azimlabsalk/Tactile-Orienting-Task/README.md

# Tactile-Orienting-Task

[Readme](https://github.com/azimlabsalk/Tactile-Orienting-Task/blob/main/Azim%20Lab_Tactile%20Orienting%20Task_README.pdf)
