azimlabsalk/Tactile-Orienting-Task/Tactile Orienting Task_files/PCB/PCB_fab_files/Bill_of_Materials-rotary_table_v2.xlsx

Comment | Value | VoltageRating | Description | Quantity | Designator | Footprint | LibRef | Manufacturer | MfgPartNumber | DigikeyPartNumber | MouserPartNumber | NP
DRV8838DSGR |  |  | IC BRIDGE DRIVER PAR 8WSON | 1 | U1 | WSON-8_PAD | DRV8838DSGR | Texas Instruments | DRV8838DSGR | 296-40081-1-ND
Green |  |  | LED | 8 | LED1, LED2, LED3, LED4, LED5, LED6, LED7, LED8 | LED0603 | LED | Wurth Elektronik | 150060VS75000 | 732-4980-1-ND
100nF | 100nF | 25V | Nonpolarized capacitor | 2 | C1, C2 | C0603 | CAP | Samsung | CL10B104KC8VPNC | 1276-CL10B104KC8VPNCCT-ND
1-1337543-0 |  |  | Female Connector, Pitch 2.54 mm, 1 x 2 Position, Height 15.8 mm, Tail Length 3.8 mm, -55 to 85 degC, RoHS, Bulk | 1 | J1 | TECO-1-1337543-0_V | CMP-2000-05853-1 | TE Connectivity |  | A97553-ND
DMN1019 |  |  | MOSFET N-CH 12V 9.3A SC59 | 1 | Q1 | SC59-3 | DMN1019UVT | Diodes Incorporated | DMN1019USN-7 | DMN1019USN-7DICT-ND
DF3EA-2P-2V(21) |  |  | CONN HEADER SMD 2POS 2MM | 1 | J4 | DF3EA-2P-2V(21) | DF3EA-2P-2V(21) | Hirose | DF3EA-2P-2V(21) | H125461CT-ND
D2510-6002-AR |  |  | CONN HEADER 10POS VERT 10GOLD | 1 | J3 | D2510-6002 | D2510-6002-AR | 3M |  | MHC10E-ND
Resistor | 10K |  | Resistor | 9 | R1, R2, R3, R4, R5, R6, R7, R8, R9 | R0603 | RES | Stackpole | RMCF0603FT10K0 | RMCF0603FT10K0CT-ND
header_40_male_dummy |  |  | row of 40 pins breakaway male 2.54mm | 2 | DUMMY1, DUMMY2 |  | header_40_male_dummy | Sullins | PRPC040SAAN-RC | S1011EC-40-ND
SI2305 |  |  | P-CHANNEL MOSFET, SOT-23 PACKAGE | 1 | Q2 | SOT23-3 | SI2305 | Micro Commercial Co | SI2305-TP | SI2305-TPMSCT-ND
