azimlabsalk/Tactile-Orienting-Task/Tactile Orienting Task_files/CAD/Assem3_all/Assem3_front.SLDASM

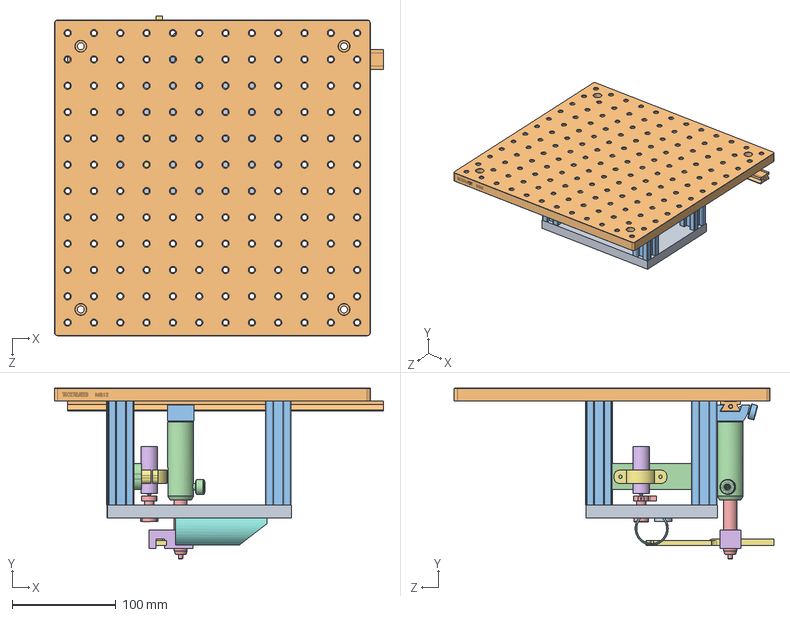
[picture p1: CAD file, 2021-02-10]
Tactile Orienting Task_files/CAD/Assem3_all/Assem3_front.SLDASM
317.5 x 165.0 x 308.4 mm
MB12-Solidworks
Colum x 4
Base plate v1
MOTOR HOLDER
190815 tuntable 14mm_v3_1.65mm_hole_side
Maxon Motor
SK_Motorclamp
ANIMLA HOLDER TUBE
ARM REST
RLA1200-Solidworks
RC1-Solidworks
PH3-Solidworks
TR3-Solidworks
headfix_joint
190604_unicorn_headpost_v1_mirror
