azimlabsalk/Tactile-Orienting-Task/Tactile Orienting Task_files/CAD/Assem3_all/ARM REST.SLDPRT

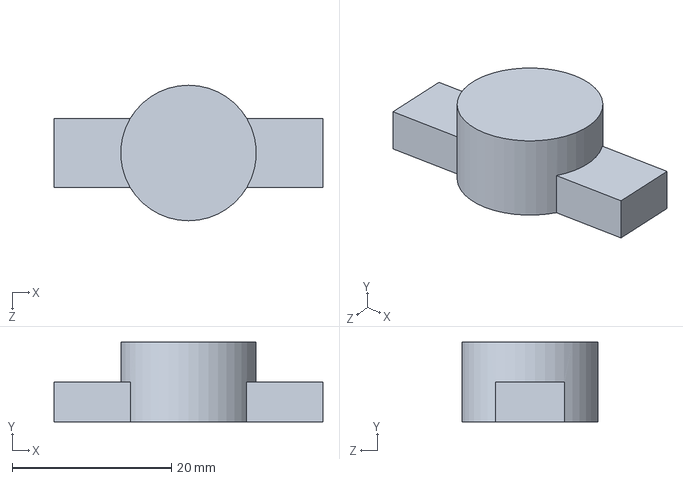
[picture p2: CAD file, 2021-02-10]
Tactile Orienting Task_files/CAD/Assem3_all/ARM REST.SLDPRT
33.7 x 10.0 x 17.0 mm
