azimlabsalk/Tactile-Orienting-Task/Tactile Orienting Task_files/CAD/Assem3_all/headfix_joint.SLDPRT

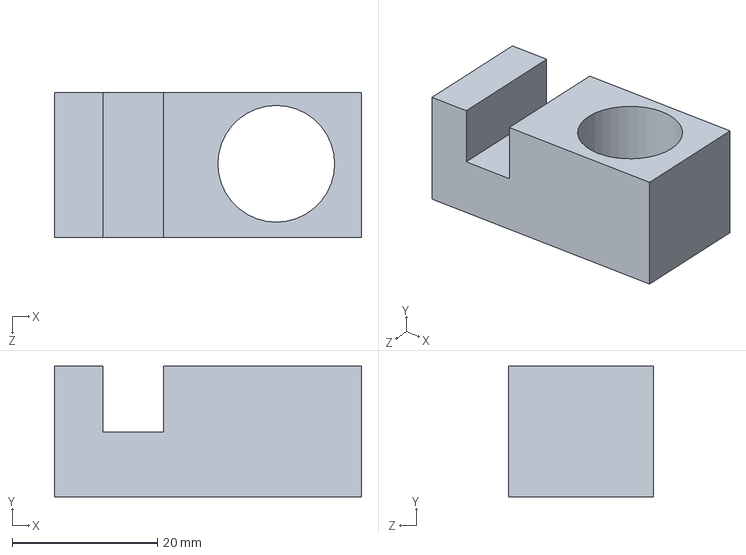
[picture p3: CAD file, 2021-02-10]
Tactile Orienting Task_files/CAD/Assem3_all/headfix_joint.SLDPRT
42.3 x 18.0 x 20.0 mm
