azimlabsalk/Tactile-Orienting-Task/Tactile Orienting Task_files/CAD/Assem3_all/MOTOR HOLDER.SLDPRT

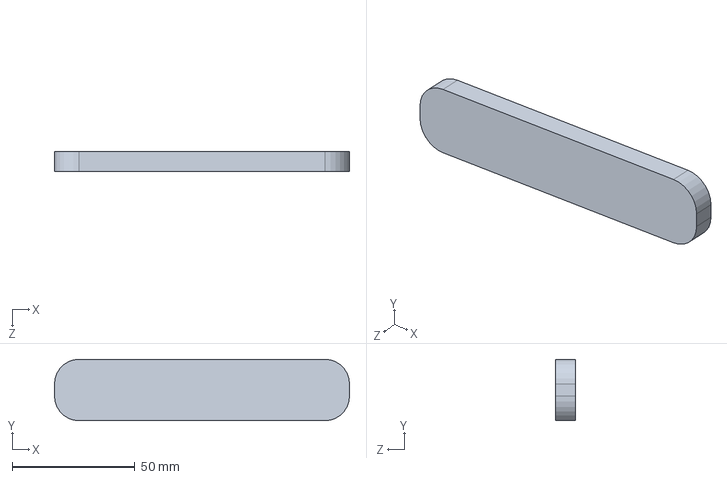
[picture p4: CAD file, 2021-02-10]
Tactile Orienting Task_files/CAD/Assem3_all/MOTOR HOLDER.SLDPRT
120.0 x 25.0 x 8.00 mm
