azimlabsalk/Tactile-Orienting-Task/Tactile Orienting Task_files/CAD/Assem3_all/PH3-Solidworks.SLDPRT

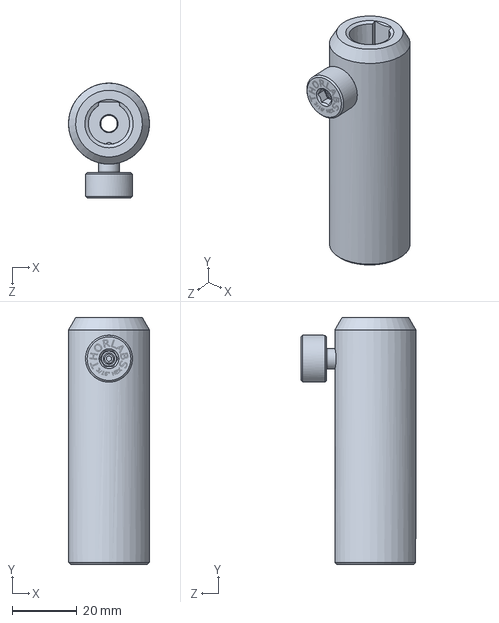
[picture p5: CAD file, 2021-02-10]
Tactile Orienting Task_files/CAD/Assem3_all/PH3-Solidworks.SLDPRT
25.0 x 76.2 x 35.4 mm
