azimlabsalk/Tactile-Orienting-Task/Tactile Orienting Task_files/CAD/Assem3_all/Base plate v1.SLDPRT

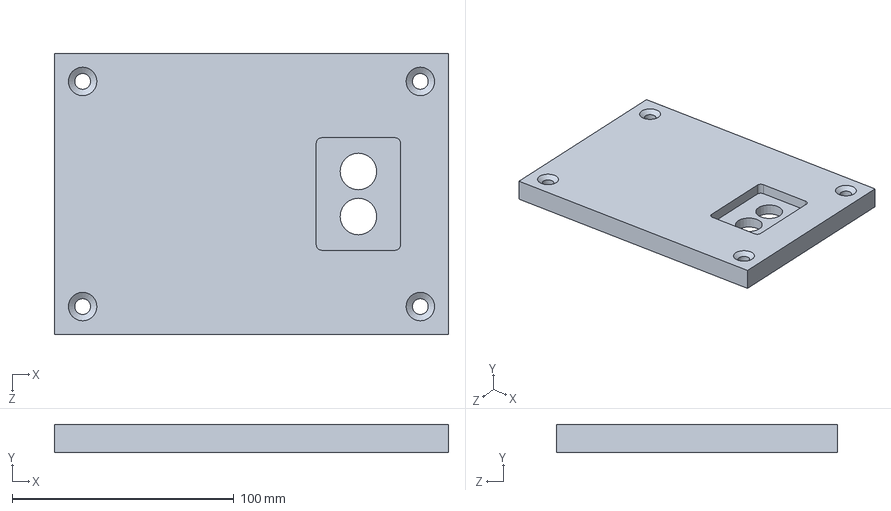
[picture p6: CAD file, 2021-02-10]
Tactile Orienting Task_files/CAD/Assem3_all/Base plate v1.SLDPRT
177.8 x 12.7 x 127.0 mm
