azimlabsalk/Tactile-Orienting-Task/Tactile Orienting Task_files/CAD/Assem3_all/Colum.SLDPRT

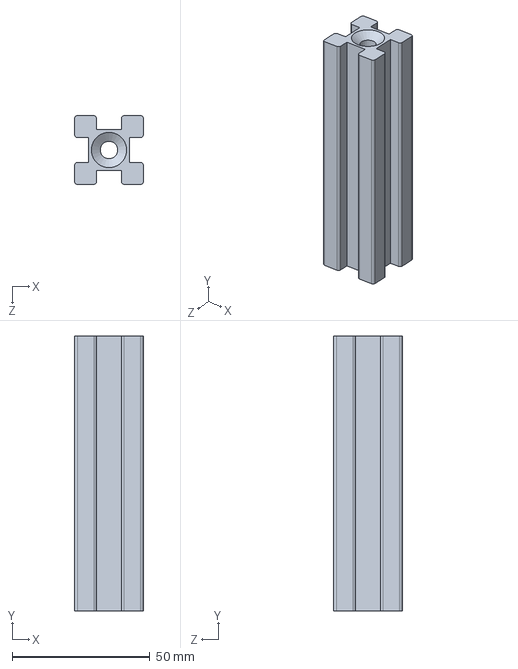
[picture p7: CAD file, 2021-02-10]
Tactile Orienting Task_files/CAD/Assem3_all/Colum.SLDPRT
25.0 x 100.0 x 25.0 mm
