azimlabsalk/Tactile-Orienting-Task/Tactile Orienting Task_files/CAD/Assem3_all/RLA1200-Solidworks.SLDPRT

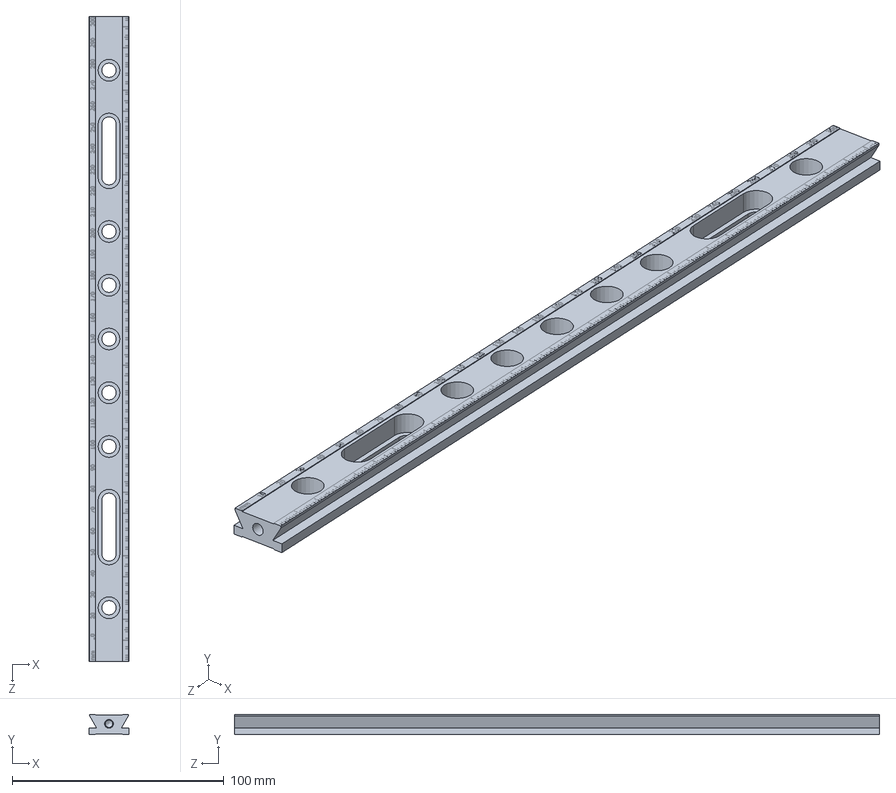
[picture p8: CAD file, 2021-02-10]
Tactile Orienting Task_files/CAD/Assem3_all/RLA1200-Solidworks.SLDPRT
19.1 x 9.52 x 304.8 mm
