azimlabsalk/Tactile-Orienting-Task/Tactile Orienting Task_files/CAD/Assem3_all/SK_Motorclamp.SLDPRT

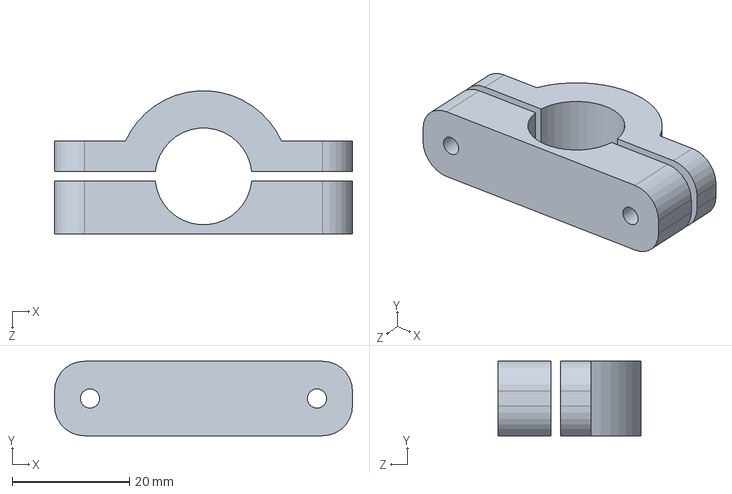
[picture p9: CAD file, 2021-02-10]
Tactile Orienting Task_files/CAD/Assem3_all/SK_Motorclamp.SLDPRT
50.8 x 12.7 x 24.4 mm
