azimlabsalk/Tactile-Orienting-Task/Tactile Orienting Task_files/CAD/Assem3_all/RC1-Solidworks.SLDPRT

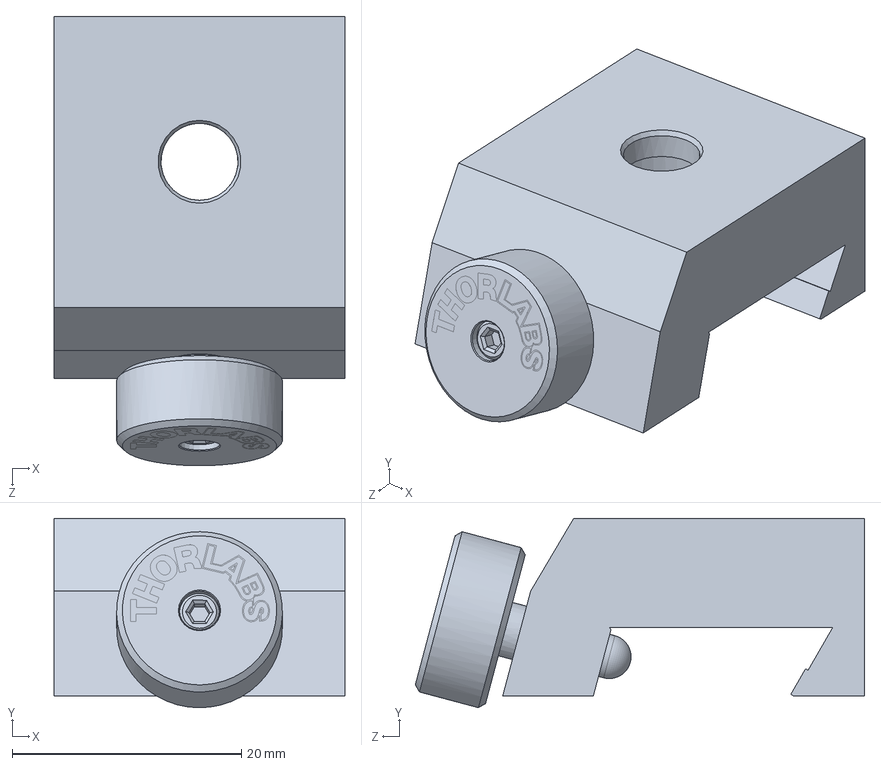
[picture p10: CAD file, 2021-02-10]
Tactile Orienting Task_files/CAD/Assem3_all/RC1-Solidworks.SLDPRT
25.4 x 16.5 x 39.2 mm
