azimlabsalk/Tactile-Orienting-Task/Tactile Orienting Task_files/CAD/Assem3_all/ANIMLA HOLDER TUBE.SLDPRT

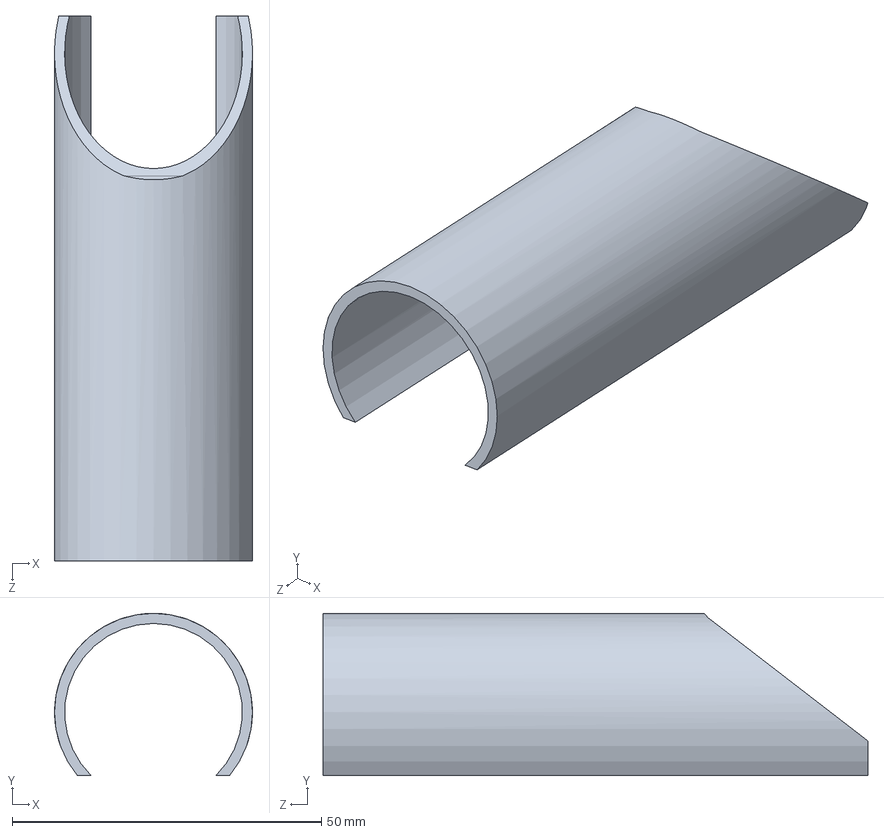
[picture p11: CAD file, 2021-02-10]
Tactile Orienting Task_files/CAD/Assem3_all/ANIMLA HOLDER TUBE.SLDPRT
32.0 x 26.2 x 88.0 mm
