azimlabsalk/Tactile-Orienting-Task/Tactile Orienting Task_files/CAD/Assem3_all/MB12-Solidworks.SLDPRT

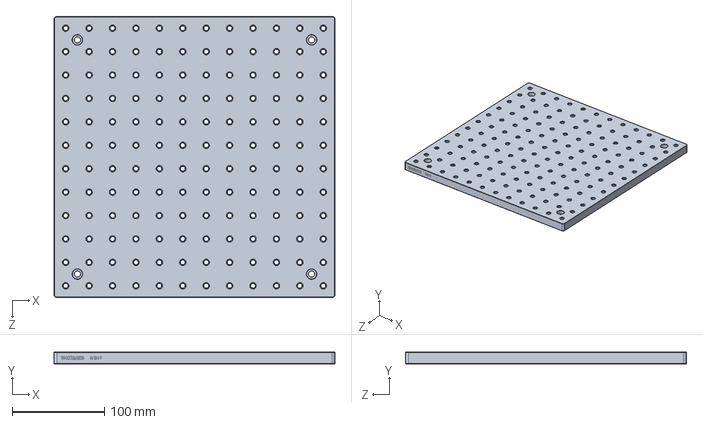
[picture p12: CAD file, 2021-02-10]
Tactile Orienting Task_files/CAD/Assem3_all/MB12-Solidworks.SLDPRT
304.8 x 12.7 x 304.8 mm
