azimlabsalk/Tactile-Orienting-Task/Tactile Orienting Task_files/CAD/Assem3_all/TR3-Solidworks.SLDPRT

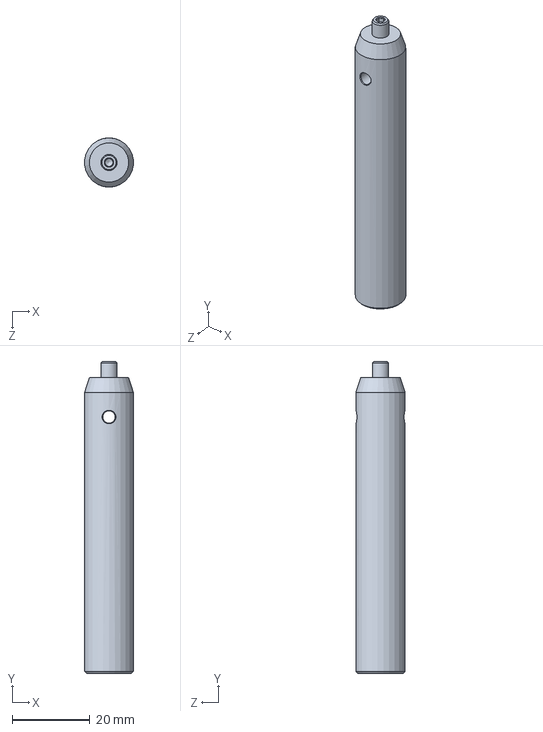
[picture p13: CAD file, 2021-02-10]
Tactile Orienting Task_files/CAD/Assem3_all/TR3-Solidworks.SLDPRT
12.6 x 80.3 x 12.7 mm
