azimlabsalk/Tactile-Orienting-Task/Tactile Orienting Task_files/CAD/Assem3_all/Maxon Motor.SLDPRT

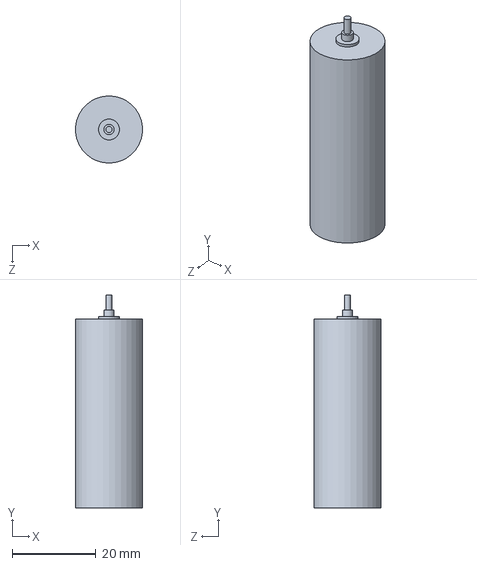
[picture p14: CAD file, 2021-02-10]
Tactile Orienting Task_files/CAD/Assem3_all/Maxon Motor.SLDPRT
15.9 x 50.8 x 16.0 mm
