azimlabsalk/Tactile-Orienting-Task/Tactile Orienting Task_files/CAD/Assem3_all/190604_unicorn_headpost_v1_mirror.SLDPRT

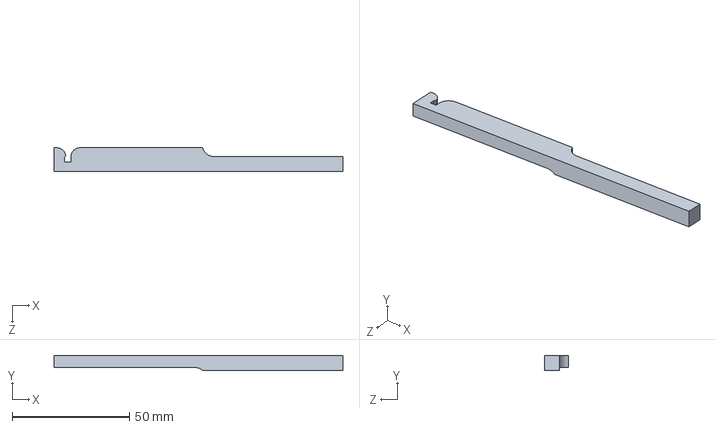
[picture p15: CAD file, 2021-02-10]
Tactile Orienting Task_files/CAD/Assem3_all/190604_unicorn_headpost_v1_mirror.SLDPRT
123.5 x 6.35 x 10.2 mm
