azimlabsalk/Tactile-Orienting-Task/Tactile Orienting Task_files/CAD/Assem3_all/190815 tuntable 14mm_v3_1.65mm_hole_side.SLDPRT

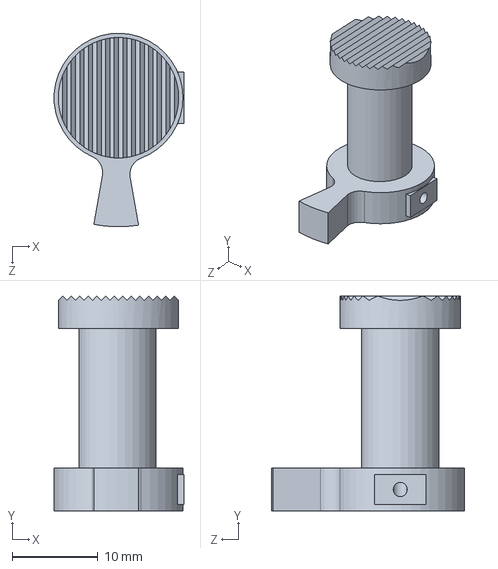
[picture p16: CAD file, 2021-02-10]
Tactile Orienting Task_files/CAD/Assem3_all/190815 tuntable 14mm_v3_1.65mm_hole_side.SLDPRT
15.1 x 25.0 x 22.5 mm
