azimlabsalk/Tactile-Orienting-Task/Tactile Orienting Task_files/PCB/PCB_fab_files/Schematic_Prints.PDF

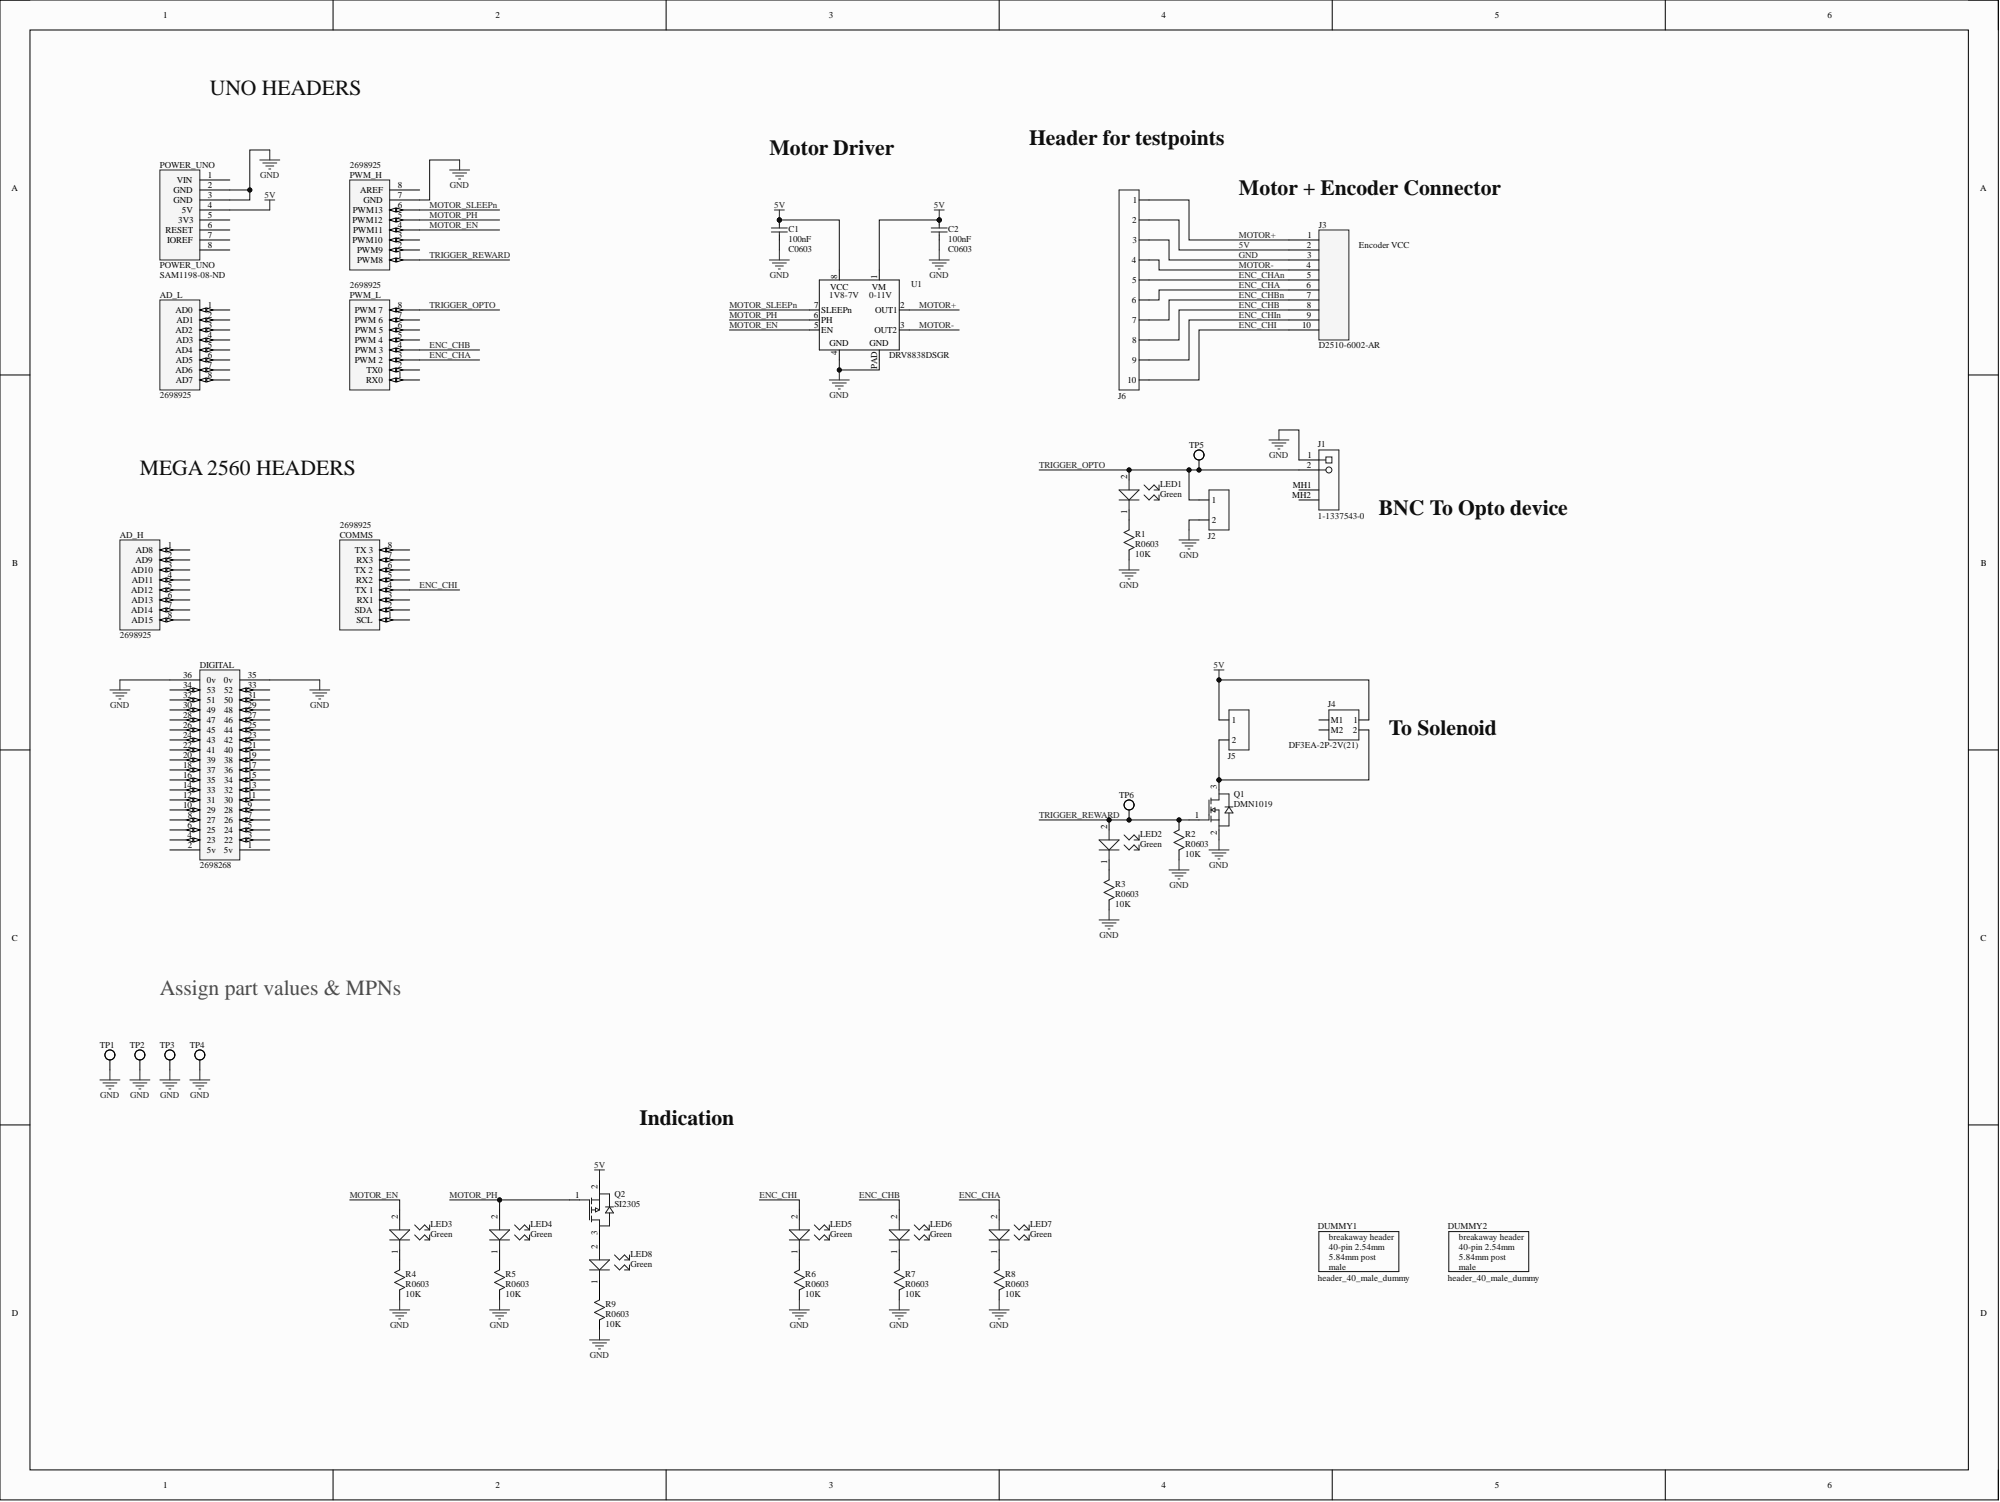
[picture p17: page 1]

GND | 3
MOTOR- | 4

BNC To Opto device

Assign part values & MPNs
