azimlabsalk/Tactile-Orienting-Task/Tactile Orienting Task_files/PCB/PCB_fab_files/Assembly_Drawing.PDF

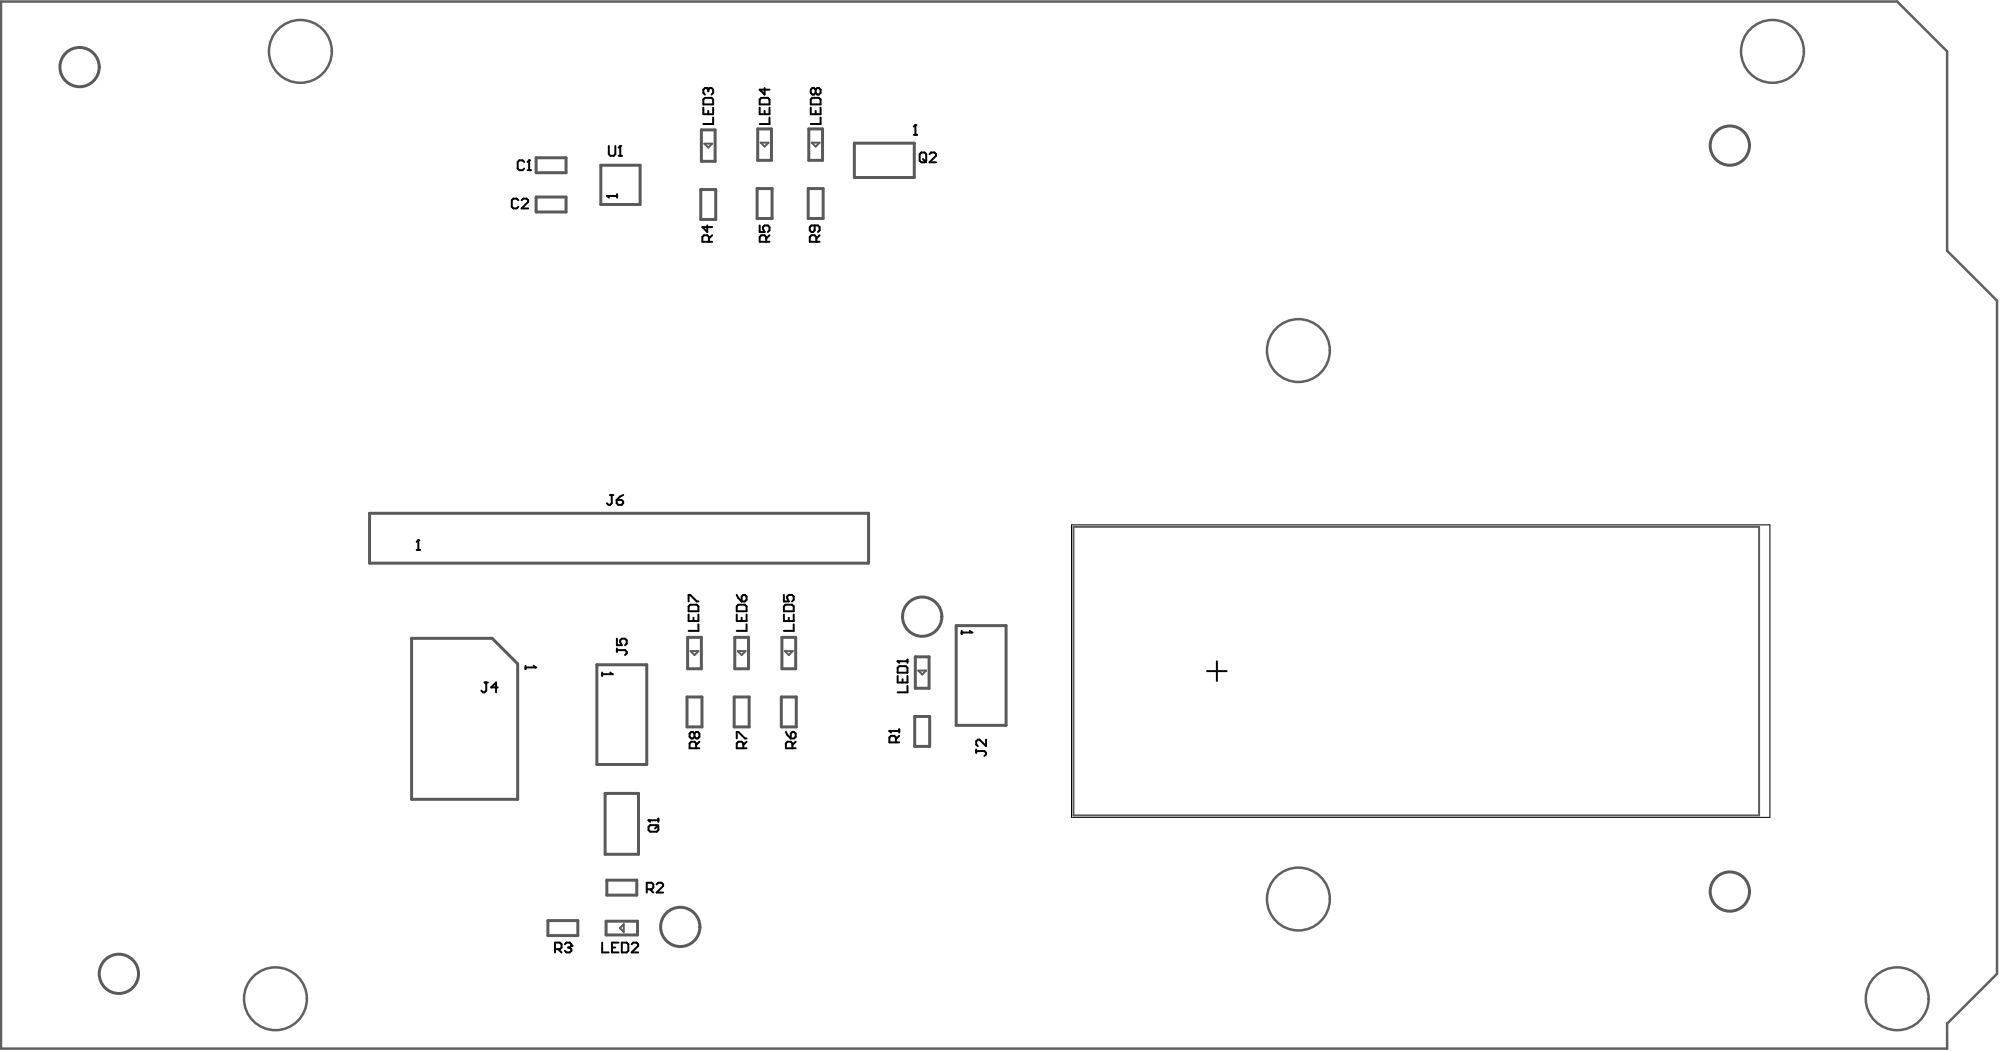
[picture p18: page 1]

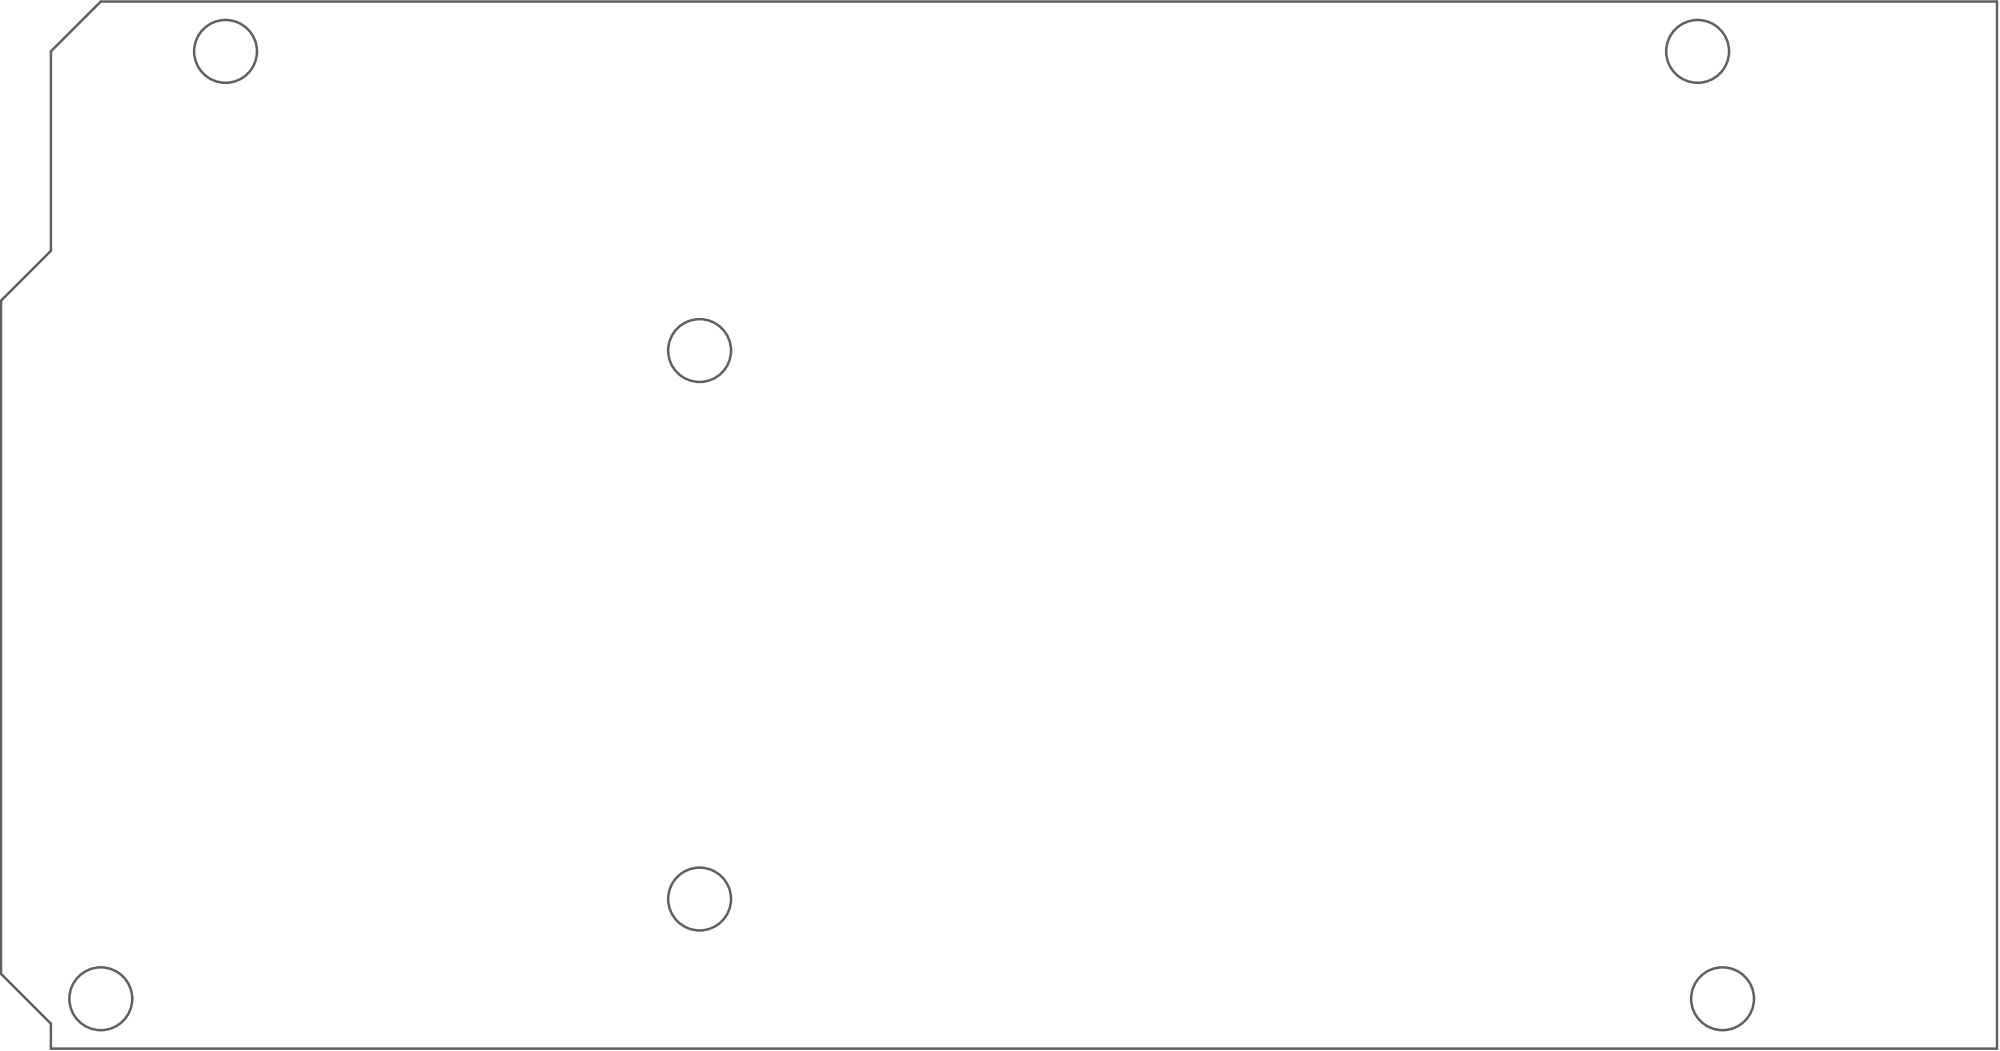
[picture p19: page 2]
