azimlabsalk/Tactile-Orienting-Task/(list of files, drawings)

Other design files:
Tactile Orienting Task_files/PCB/PCB_design_files_Altium_DXP_20/Mark_Library.SchLib
Tactile Orienting Task_files/PCB/PCB_design_files_Altium_DXP_20/rotary_table_v2.pcbdoc
Tactile Orienting Task_files/PCB/PCB_design_files_Altium_DXP_20/rotary_table_v2.PrjPcb
Tactile Orienting Task_files/PCB/PCB_design_files_Altium_DXP_20/rotary_table_v2.SchDoc
